ViradMunir/RowSense/(commit log)

2026-09-10 Add esp32 s3 bridge file
2026-09-10 Add renamed mode switch script
